PaxInstruments/nokia-phone-arduino-shield/Resources/conn_pinout.jpg

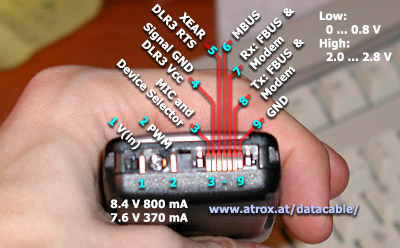
Resources/conn_pinout.jpg
