PaxInstruments/nokia-phone-arduino-shield/README.md

# Pax Instruments
# Nokia Phone Arduino Shield

## Overview
This project is the Pax Instruments Nokia Phone Arduino Shield
