PaxInstruments/nokia-phone-arduino-shield/Electronics/versions/nokia-phone-arduino-shield-v1/nokia-phone-arduino-shield.brd

## EAGLE design Electronics/versions/nokia-phone-arduino-shield-v1/nokia-phone-arduino-shield.brd (2015-05-25)

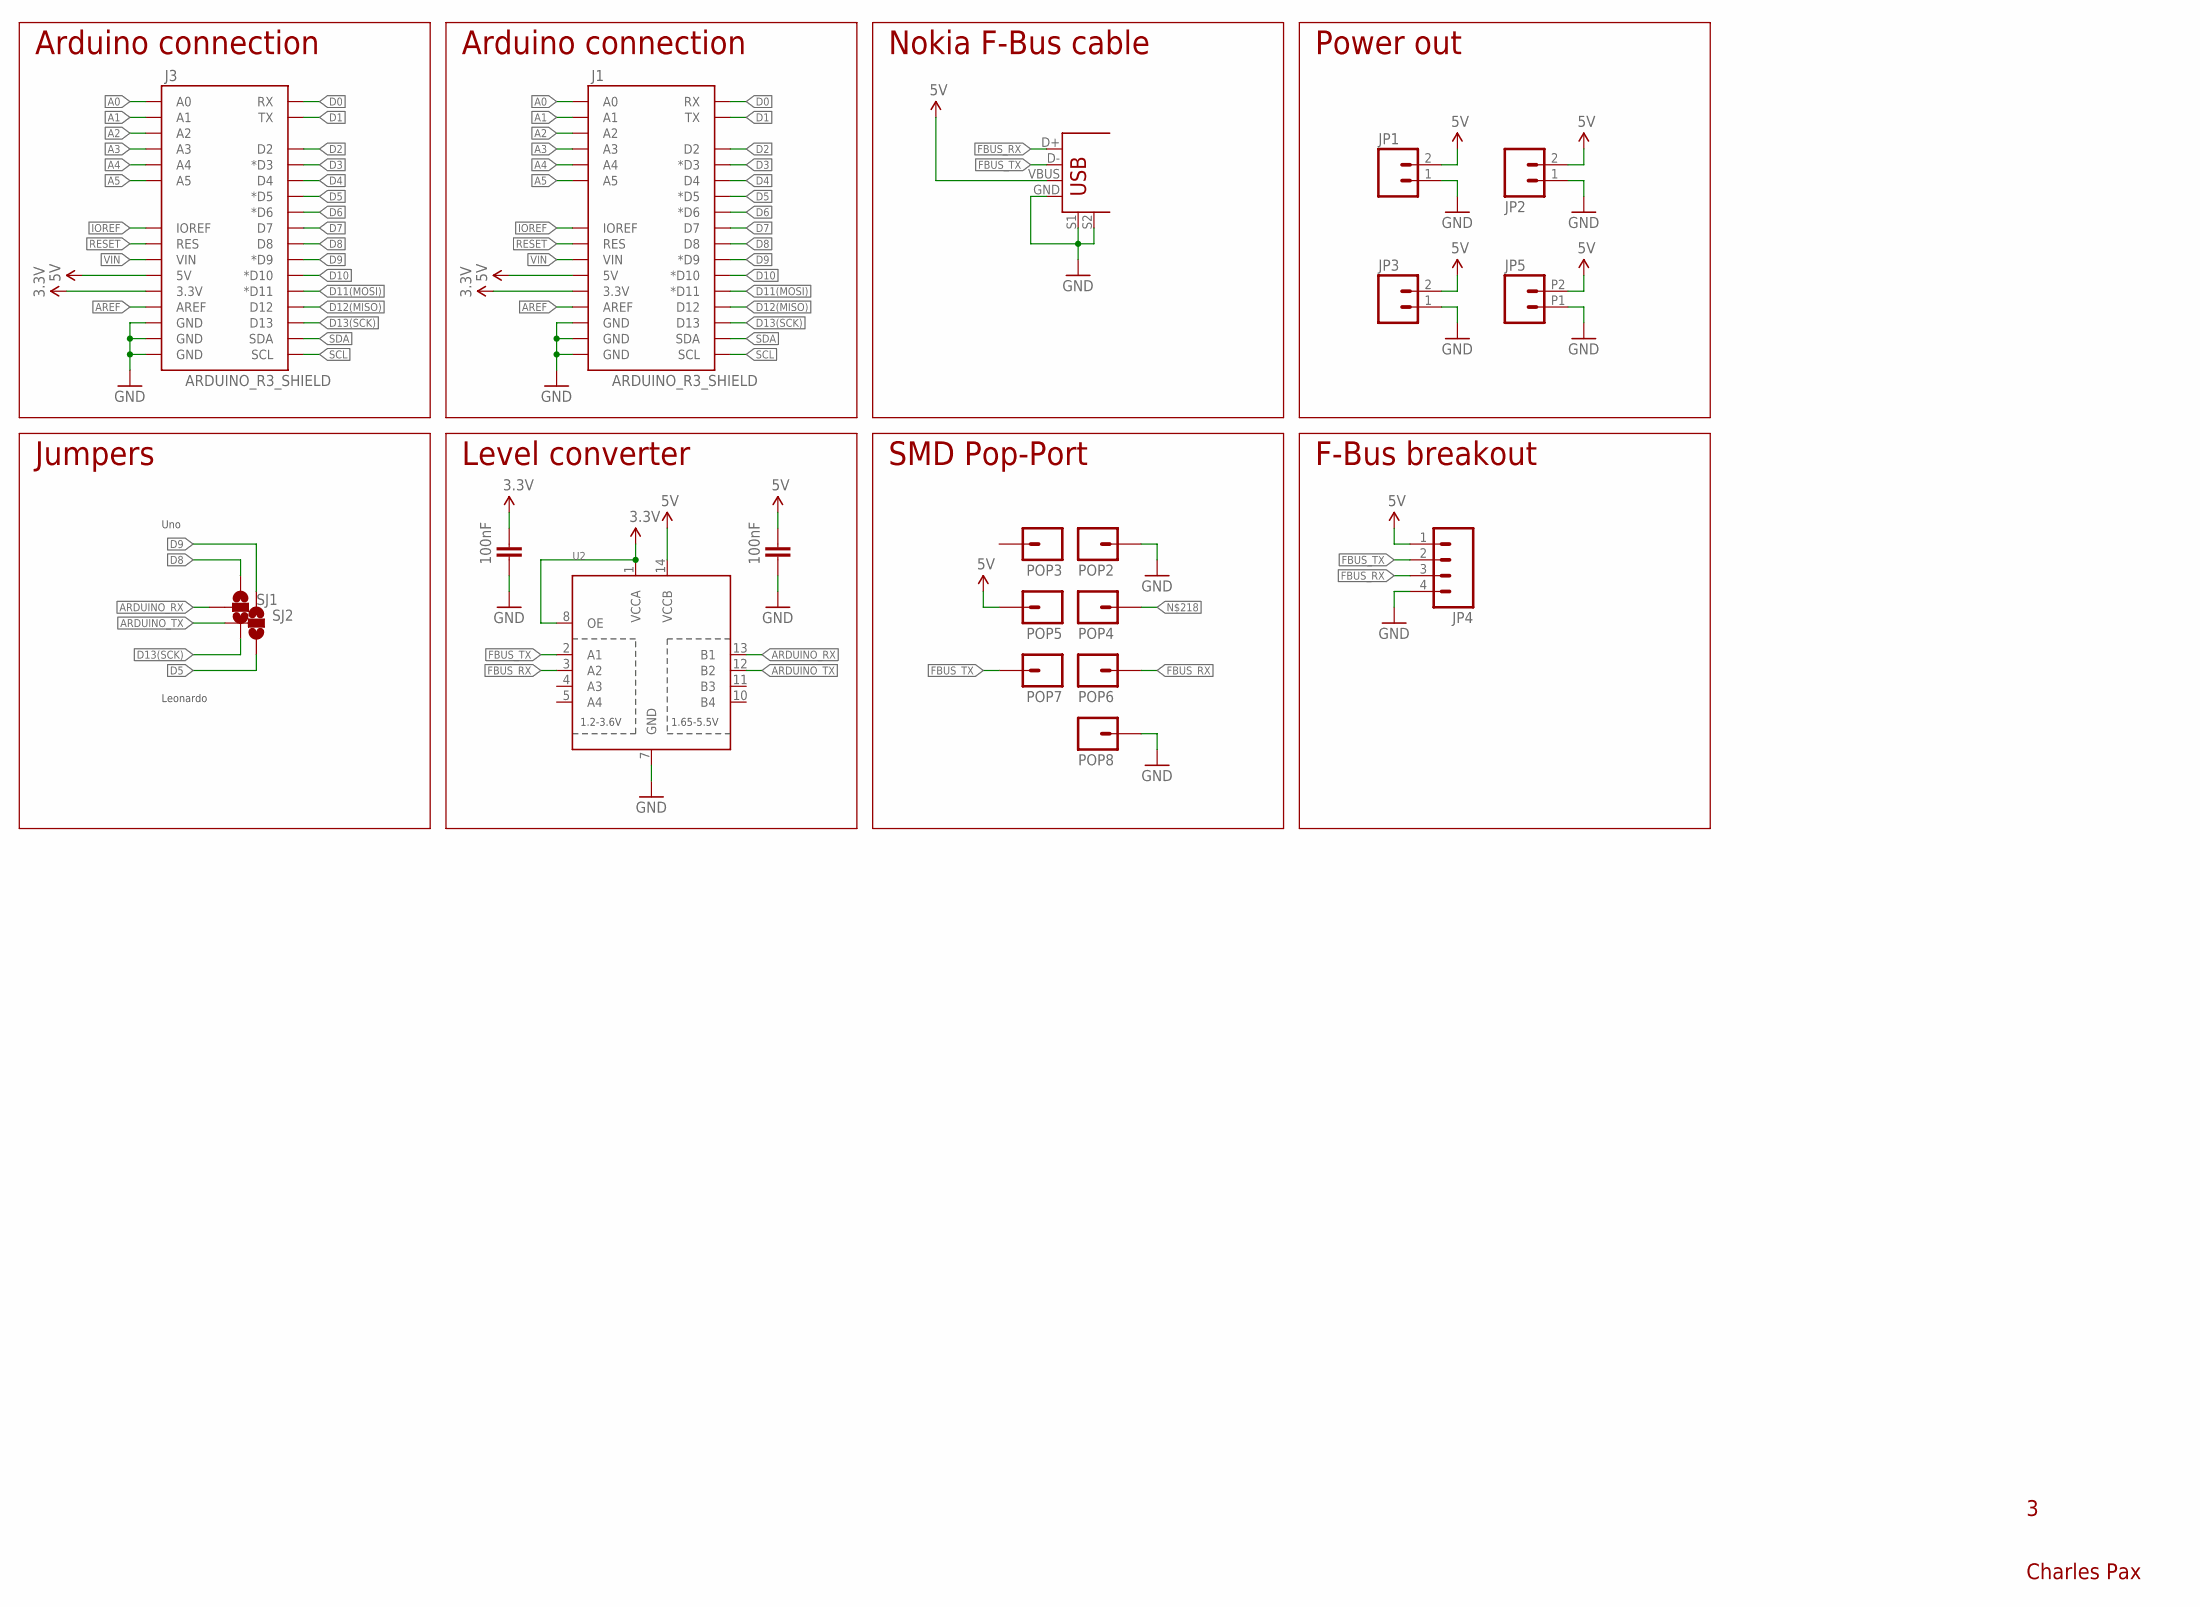
[picture p2: schematic nokia-phone-arduino-shield.sch]

Parts:
C3, C4: 100nF; SPARKFUN-CAPACITORS_0603-CAP; MPN CL10B104KO8NNNC
J1, J3: ARDUINO_R3_SHIELD; UNO_R3_SHIELD_NOLABELS_LOCK
JP1, JP3: M02LOCK; 1X02_LOCK
JP2: M02-JST-2MM-SMT; JST-2-SMD
JP4: M04LOCK; 1X04_LOCK
JP5: M022.54MM_SCREWTERM; 1X02_2.54_SCREWTERM
POP2, POP3, POP4, POP5, POP6, POP7, POP8: M01SMD-4.5X1.5; PAD-1.5X4.5
SJ1, SJ2: SOLDERJUMPER_2WAYS; SJ_3
U2: TXB0104PWRSOIC14; SO14; MPN TXB0104DR
U$2: USB+SHIELDUSB-A-S-NOSILK-FEMALE; USB-A-S-NOSILK-FEMALE

Connections:
3.3V: C3.2, J1.3.3V, J3.3.3V, U2.1 (VCCA), U2.8 (OE)
5V: C4.2, J1.5V, J3.5V, JP1.2, JP2.2 (1), JP3.2, JP4.1, JP5.P2 (2), POP5.P$1, U2.14 (VCCB), U$2.VBUS
A0: J1.A0, J3.A0
A1: J1.A1, J3.A1
A2: J1.A2, J3.A2
A3: J1.A3, J3.A3
A4: J1.A4, J3.A4
A5: J1.A5, J3.A5
ARDUINO_RX: SJ1.2, U2.13 (B1)
ARDUINO_TX: SJ2.2, U2.12 (B2)
AREF: J1.AREF, J3.AREF
D0: J1.RX, J3.RX
D1: J1.TX, J3.TX
D2: J1.D2, J3.D2
D3: J1.D3 (*D3), J3.D3 (*D3)
D4: J1.D4, J3.D4
D5: J1.D5 (*D5), J3.D5 (*D5), SJ2.3
D6: J1.D6 (*D6), J3.D6 (*D6)
D7: J1.D7, J3.D7
D8: J1.D8, J3.D8, SJ1.1
D9: J1.D9 (*D9), J3.D9 (*D9), SJ2.1
D10: J1.D10 (*D10), J3.D10 (*D10)
D11(MOSI): J1.D11 (*D11), J3.D11 (*D11)
D12(MISO): J1.D12, J3.D12
D13(SCK): J1.D13, J3.D13, SJ1.3
FBUS_RX: JP4.3, POP6.P$1, U2.3 (A2), U$2.D+
FBUS_TX: JP4.2, POP7.P$1, U2.2 (A1), U$2.D-
GND: C3.1, C4.1, J1.GND@0 (GND), J1.GND@1 (GND), J1.GND@2 (GND), J3.GND@0 (GND), J3.GND@1 (GND), J3.GND@2 (GND), JP1.1, JP2.1 (2), JP3.1, JP4.4, JP5.P1 (1), POP2.P$1, POP8.P$1, U2.7 (GND), U$2.GND, U$2.S1, U$2.S2
IOREF: J1.IOREF, J3.IOREF
RESET: J1.RES, J3.RES
SCL: J1.SCL, J3.SCL
SDA: J1.SDA, J3.SDA
VIN: J1.VIN, J3.VIN

Notes on the sheet:
Charles Pax
Arduino connection
Jumpers
Level converter
Nokia F-Bus cable
SMD Pop-Port
Power out
Leonardo
Uno
F-Bus breakout

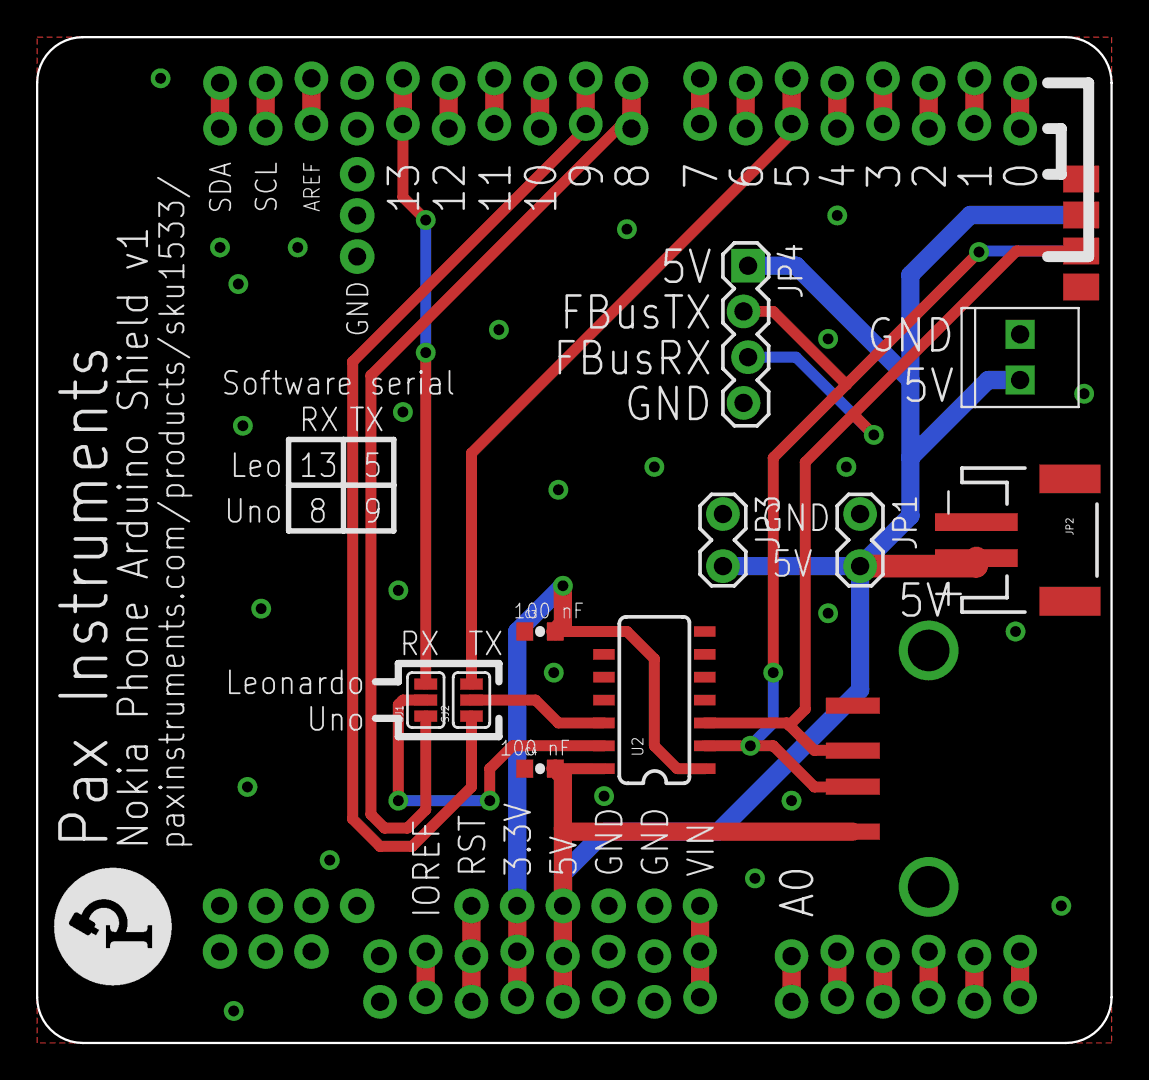
[picture p3: board nokia-phone-arduino-shield.brd from above]

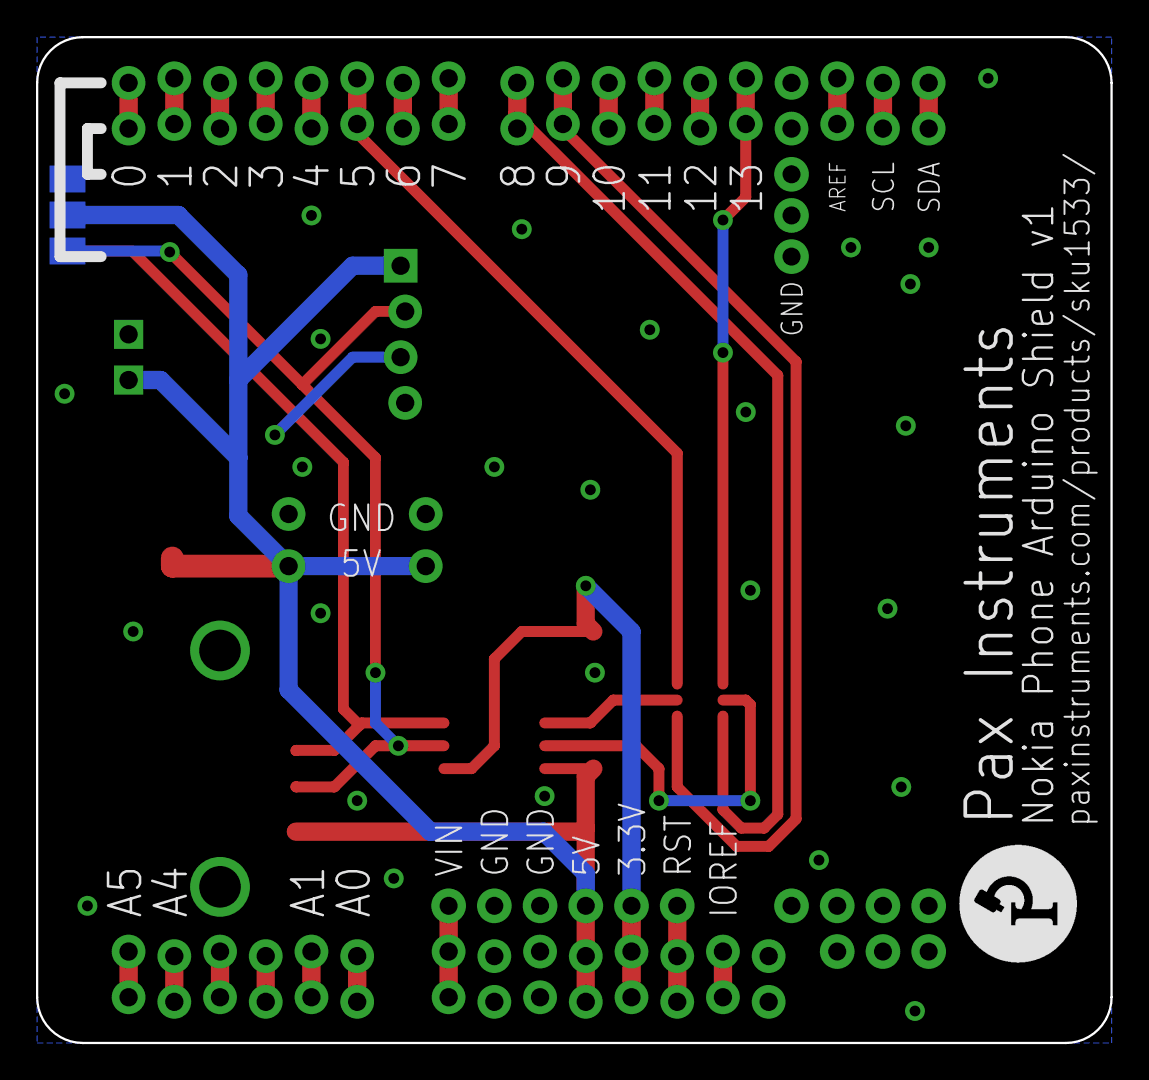
[picture p4: board nokia-phone-arduino-shield.brd from below]

Board: 2 copper layers, 59.7 x 55.9 mm, 22 parts (4 on the bottom side), 33 nets.

Other parts of the board:
U$1, U$6: PAXINSTRUMENT_LOGO
