PaxInstruments/nokia-phone-arduino-shield/(threads)

Thread 1 (2015-05-24):

Return string with strange output

charlespax, 2015-05-24:
In commit 0eeef811dd4affe6e0fe676b9d5701c01e1b6d6a this code

```
#include <AltSoftSerial.h>
#include "FBus.h"
AltSoftSerial altSerial;
FBus myPhone(&altSerial);

void setup() {
    Serial.begin(115200);
    delay(200);
    altSerial.begin(115200);
    delay(200);
}

void loop() {
    Serial.print("SW version: ");Serial.println(myPhone.softwareVersion());
    Serial.print("HW version: ");Serial.println(myPhone.hardwareVersion());
    Serial.print("Date code: ");Serial.println(myPhone.dateCode());
    Serial.println();
    delay(1000);
}
```

outputs

```
SW version: 06.31 �
HW version: RH-19 �
Date code: 25-11-05 �
```

In case it doesn't render here is a screenshot of my serial terminal.
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

charlespax, 2015-06-24:
This is just the terminating characters at the end of a string. The strange character was displaying because the individual bytes of the byte array were being passed to the serial port. This is no longer a problem.

Closed 2015-06-24.

Thread 3 (2015-05-26):

Compatible phone list

charlespax, 2015-05-26:
The target phone is the Nokia 3100. Here is the full list of compatible phones that use commands from nk6510.c.: 6510, 6310, 8310, 6310i, 6360, 6610, 6100, 5100, 3510, 3510i, 3595, 6800, 6810, 6820, 6820b, 6610i, 6230, 6650, 7210, 7250, 7250i, 7600, 6170, 6020, 6230i, 5140, 5140i, 6021, 6500, 6220, 3120b, 3100, 3120, 6015i, 6101, 6680, 6280, 3220, 6136, 6233, 6822, 6300, 6030, 3110c, series60, series40

We can have a function that checks if the board is connected to one of these boards. If not, throw an error. This would probably be a waste of memeory.

charlespax, 2015-06-24:
That list was given on some site. We have an issue to determine which gnokii protocol to use. See https://github.com/PaxInstruments/nokia-phone-arduino-shield/issues/8.

Closing issue.

protological, 2015-06-25:
I don't think the 3100 was developed from the 6510, the Wikipedia page says it is from the 6100.  The 3110,3210 and 3310 are from the 6510.

Closed 2015-06-24.

Thread 5 (2015-06-24):

Shield connector mismatch

charlespax, 2015-06-24:
"It appears that the Nokia shield needs to be modified to match the connector. I was looking at the phone schematic and the connector pins don't match up with the TX and RX lines on the board. It looks like you have RX connected to the forth pin (p5) rather than the sixth pin (p7)." -Drew
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

"I think I was off by 1, it might be ok, confirming now" -Drew

charlespax, 2015-06-24:
"I got confused with the RX/TX and the connector, I thought it was off by one. Good news, success getting a response from the phone!! I should be able to send a text to you and chris, send me your phone number" -Drew

charlespax, 2015-06-24:
Okay, it there an actual problem here or was is just a counting issue?

Here is the schematic.

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

protological, 2015-06-25:
I looked at the schematic and traced out the connections and everything is good.  I was thinking from the processor side of things and not from the phone side, so I was trying to send to the phone's RX port.  Everything matches up and I was able to send and receive data packets.

charlespax, 2015-06-25:
Got it. Closing issue.

Closed 2015-06-25.

Thread 6 (2015-06-24):

SMS message format

charlespax, 2015-06-24:
The firmware needs the ability to package a SMS message.

charlespax, 2015-06-24:
"I've updated the Arduino code to format a correct SMS packet and a hardware request packet.  The next step is to get a response from the phone to confirm the packets are correct and build a handler for the data back. I could lift the RX pin from the connector and use a logic analyzer to confirm the correct packet." -Drew

charlespax, 2015-06-24:
Awesome. Do whatever you need to the board. We have more PCBs. Though I'm not sure if I have additional level shifters.

charlespax, 2015-06-24:
"I was able to format messages from the Arduino and send them via FBus, I saw the SW/HW version response and an ACK message from the phone as expected." -Drew

protological, 2015-06-25:
The firmware has been updated to send and receive FBus packets, we can correctly send the HWSW request message, receive the ACK, ACK the ACK, receive the HWSW response and ACK that so it is only sent a single time.

The ACK is handled automatically in the class and the user doesn't need to deal with it.  I've also added functions for "resetting" the bus by sending 0x55 values.

Thread 9 (2015-06-24):

Activate reading FBus based on serial interrupt

charlespax, 2015-06-24:
Each incoming FBus byte should be process individually. The process can probably run hundreds of instructions between each incoming byte. It would be good to have the incoming byte processing funciton be triggered on a serial input interrupt.

I believe that when the phone receives a text message it sends a packet on the FBus line. If this is true, a microcontroller would be able to just sit and wait until there is a serial input interrupt.

protological, 2015-06-25:
I added a process() routine that checks the queue and processes all bytes when it sees some.  This process() routine should be called in the loop() routine.  We might want to rename it loop() to make it more clear

charlespax, 2015-06-25:
Rename process() to loop()? Does that create conflicts with the default loop() function in Arduino?

protological, 2015-06-25:
No, this loop will be in the class

charlespax, 2015-06-25:
Okay, so this would be addressed with my `myPhone.loop()` or similar?

protological, 2015-06-26:
Yes.  We could add interrupts, it would be pretty straight forward but it would make it more difficult for the user to switch serial ports.  Based on the AttachInterrupt() page (https://www.arduino.cc/en/Reference/AttachInterrupt) the interrupts are constants, we could have a #define that says which serial port we are using, but passing the Serial1 object on class creation seems a little cleaner

charlespax, 2015-06-27:
[SerialEvent()](https://www.arduino.cc/en/Tutorial/SerialEvent) is interesting. It's not an interrupt driven function, but it's called after loop().

[This post](http://forum.arduino.cc/index.php?topic=45076.0) states, "The serial data is captured using an interrupt to put each character into the serial input buffer. If you add any additional processing to that interrupt or trigger another interrupt then you may lose incoming characters because the arduino disables interrupts when it is in an interrupt handler." I think this relates to an interrupt on one of the serial port pins.

Thread 10 (2015-06-25):

Use data cable to communicate with phone

charlespax, 2015-06-25:
I can't use the data cable to communicate with a phone unless there is also a phone connected to the PCB mounted connector. Very strange.
