PaxInstruments/nokia-phone-arduino-shield/(commit log)

2015-05-19 Added nearly blank Arduino sketch.
2015-05-20 Works using AltSoftSerial.h to connect to the phone on pin 8 and 9 on the Arduino Uno.
2015-05-23 Fixed a leading linebreak issue. Still have strange trailing characters.
    [FBus.cpp, nokia-phone-arduino-shield.ino]
2015-05-25 Added a basic shield with connections. Need to route.
    [nokia-phone-arduino-shield.brd, nokia-phone-arduino-shield.sch]
2015-05-25 Routed and ready.
    [nokia-phone-arduino-shield.brd, nokia-phone-arduino-shield.sch]
2015-05-25 Added v1 files. Ordering now.
    [nokia-phone-arduino-shield.brd, nokia-phone-arduino-shield.sch]
2015-05-25 Added gnokii documentation for the Nokia 3100 phone and F-Bus protocol. Added template functions for Arduino sketch. Added F-Bus research notes.
2015-05-28 This shoudl work. Not sure what's wrong. Hardware problem. Added notes.
    [FBus.cpp]
2015-05-28 Using SoftwareSerial.h and not AltSoftwareSerial.h, which seems to have some interrupt stuff that breaks up the initialize() command.
2015-05-28 Disabled getting additional sw/hw info until messages get parsed correctly.
    [nokia-phone-arduino-shield.ino]
2015-06-05 Automatically sends the correct acknowledgement packet.
    [FBus.cpp, FBus.h, nokia-phone-arduino-shield.ino]
2015-06-06 Modified for Arduino Leonardo. Added debug info.
2015-06-07 Switch statement added to Arduion code. Code compiles, but it not implemented.
2015-06-11 The packet structure method can now do proper checksums and send the correct acknowledgement packet.
    [FBus.cpp, FBus.h, nokia-phone-arduino-shield.ino]
2015-06-11 Added requestHWSW(). Fixed a packetSend() bug.
    [FBus.cpp, FBus.h, nokia-phone-arduino-shield.ino]
2015-06-22 Updated variable names to no conflict with the user code, added some new types that match with frame structure on the wire. Added some new logic for sending packet.
    Stripped down the main code for testing
2015-06-23 Got TX packet working, checksum correct, endianness is correct and it uses fewer loops
    [FBus.cpp, FBus.h, nokia-phone-arduino-shield.ino]
2015-06-25 Fixed ACKing packets, added some new 'states' to the RX packet so we know if we are NEW, RECEIVING, or READY for processing. Updated comments and organized everything so the header matches the body.
    Fixed up the ino file to be a good example of how this works
    [FBus.cpp, FBus.h, nokia-phone-arduino-shield.ino]
2016-08-26 Added randome files. Backing up.
    [CopperBottom.GBL, CopperTop.GTL, Dimension.GKO, SikscreenBottom.GBO, SilkscreenTop.GTO, SolderPasteBottom.GBP, SoldermaskBottom.GBS, SoldermaskTop.GTS]
